parkerlab-external/UltracoldPCB-DDS/DDS.brd

## EAGLE design DDS.brd (2025-03-03)

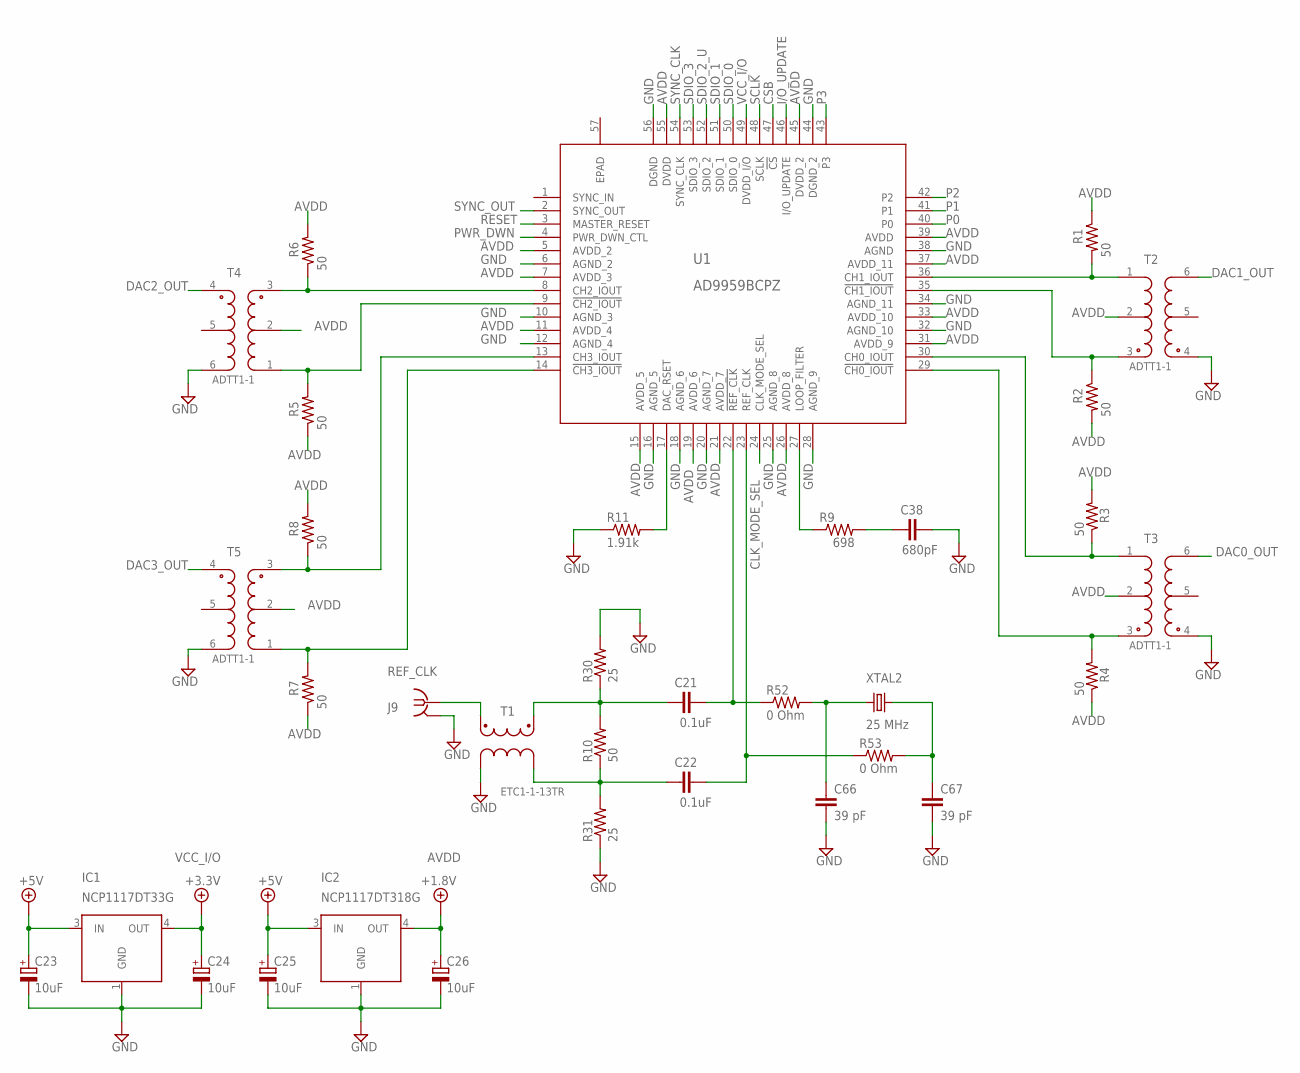
[picture p1: schematic DDS.sch, sheet 1]

Parts:
C21, C22: 0.1uF; C0402; MPN C0402C104K4RACTU
C23, C24, C25, C26: 10uF; CT3528; MPN T494B106K025AT
C38: 680pF; C0805; MPN MC0805N681J101CT
C66, C67: 39 pF; C0805; MPN MC0805N390J500CT
IC1: NCP1117DT33G; D-PAK_TO252AA; MPN NCP1117DT33G
IC2: NCP1117DT318G; D-PAK_TO252AA; MPN NCP1117DT18G
J9: REF_CLK; BU-SMA-V; MPN 142-0701-231
R1, R2, R3, R4, R5, R6, R7, R8, R10: 50; R0603; MPN CRCW060350R0FKEA
R9: 698; R0603; MPN ERJ-3EKF6980V
R11: 1.91k; R0603; MPN CRCW06031K91FKEA
R30, R31: 25; R0402; MPN NRC04F24R9TRF
R52, R53: 0 Ohm; R0402; MPN ERJ2GE0R00X
T1: ETC1-1-13TR; SM22
T2, T3, T4, T5: ADTT1-1; ADTT
U1: AD9959BCPZ; CP_56_1_ADI
XTAL2: 25 MHz; HC49UP

Connections:
+5V: C23.+, C25.+, IC1.3 (IN), IC2.3 (IN); also elsewhere on the board
AVDD: C26.+, IC2.4 (OUT), R1.1, R2.2, R3.2, R4.1, R5.1, R6.2, R7.1, R8.2, T2.2 (PRI0), T3.2 (PRI0), T4.2 (PRI0), T5.2 (PRI0), U1.5 (AVDD_2), U1.7 (AVDD_3), U1.11 (AVDD_4), U1.15 (AVDD_5), U1.19 (AVDD_6), U1.21 (AVDD_7), U1.26 (AVDD_8), U1.31 (AVDD_9), U1.33 (AVDD_10), U1.37 (AVDD_11), U1.39 (AVDD), U1.45 (DVDD_2), U1.55 (DVDD); also elsewhere on the board
CLK_MODE_SEL: U1.24 (CLK_MODE_SEL); also elsewhere on the board
CSB: U1.47 (!CS); also elsewhere on the board
DAC0_OUT: T3.6 (SEC-); also elsewhere on the board
DAC1_OUT: T2.6 (SEC-); also elsewhere on the board
DAC2_OUT: T4.4 (SEC+); also elsewhere on the board
DAC3_OUT: T5.4 (SEC+); also elsewhere on the board
GND: C23.-, C24.-, C25.-, C26.-, C38.2, C66.2, C67.2, IC1.1 (GND), IC2.1 (GND), J9.2 (GND), J9.3 (GND), J9.4 (GND), J9.5 (GND), R11.1, R30.2, R31.1, T1.4, T2.4 (SEC+), T3.4 (SEC+), T4.6 (SEC-), T5.6 (SEC-), U1.6 (AGND_2), U1.10 (AGND_3), U1.12 (AGND_4), U1.16 (AGND_5), U1.18 (AGND_6), U1.20 (AGND_7), U1.25 (AGND_8), U1.28 (AGND_9), U1.32 (AGND_10), U1.34 (AGND_11), U1.38 (AGND), U1.44 (DGND_2), U1.56 (DGND); also elsewhere on the board
I/O_UPDATE: U1.46 (I/O_UPDATE); also elsewhere on the board
unnamed: C21.1, R10.2, R30.1, T1.1
unnamed: R6.1, T4.3 (PRI+), U1.8 (CH2_IOUT)
unnamed: R5.2, T4.1 (PRI-), U1.9 (!CH2_IOUT)
unnamed: R4.2, T3.3 (PRI+), U1.29 (!CH0_IOUT)
unnamed: R1.2, T2.1 (PRI-), U1.36 (CH1_IOUT)
unnamed: R11.2, U1.17 (DAC_RSET)
unnamed: R9.1, U1.27 (LOOP_FILTER)
unnamed: C38.1, R9.2
unnamed: R7.2, T5.1 (PRI-), U1.14 (!CH3_IOUT)
unnamed: C66.1, R52.2, XTAL2.1
unnamed: R3.1, T3.1 (PRI-), U1.30 (CH0_IOUT)
unnamed: C67.1, R53.2, XTAL2.2
unnamed: C21.2, R52.1, U1.22 (!REF_CLK)
unnamed: C22.1, R10.1, R31.2, T1.3
unnamed: J9.1, T1.5
unnamed: C22.2, R53.1, U1.23 (REF_CLK)
unnamed: R8.1, T5.3 (PRI+), U1.13 (CH3_IOUT)
unnamed: R2.1, T2.3 (PRI+), U1.35 (!CH1_IOUT)
P0: U1.40 (P0); also elsewhere on the board
P1: U1.41 (P1); also elsewhere on the board
P2: U1.42 (P2); also elsewhere on the board
P3: U1.43 (P3); also elsewhere on the board
PWR_DWN: U1.4 (PWR_DWN_CTL); also elsewhere on the board
RESET: U1.3 (MASTER_RESET); also elsewhere on the board
SCLK: U1.48 (SCLK); also elsewhere on the board
SDIO_0: U1.50 (SDIO_0); also elsewhere on the board
SDIO_1: U1.51 (SDIO_1); also elsewhere on the board
SDIO_2_U: U1.52 (SDIO_2); also elsewhere on the board
SDIO_3: U1.53 (SDIO_3); also elsewhere on the board
SYNC_CLK: U1.54 (SYNC_CLK)
SYNC_OUT: U1.2 (SYNC_OUT)
VCC_I/O: C24.+, IC1.4 (OUT), U1.49 (DVDD_I/O); also elsewhere on the board

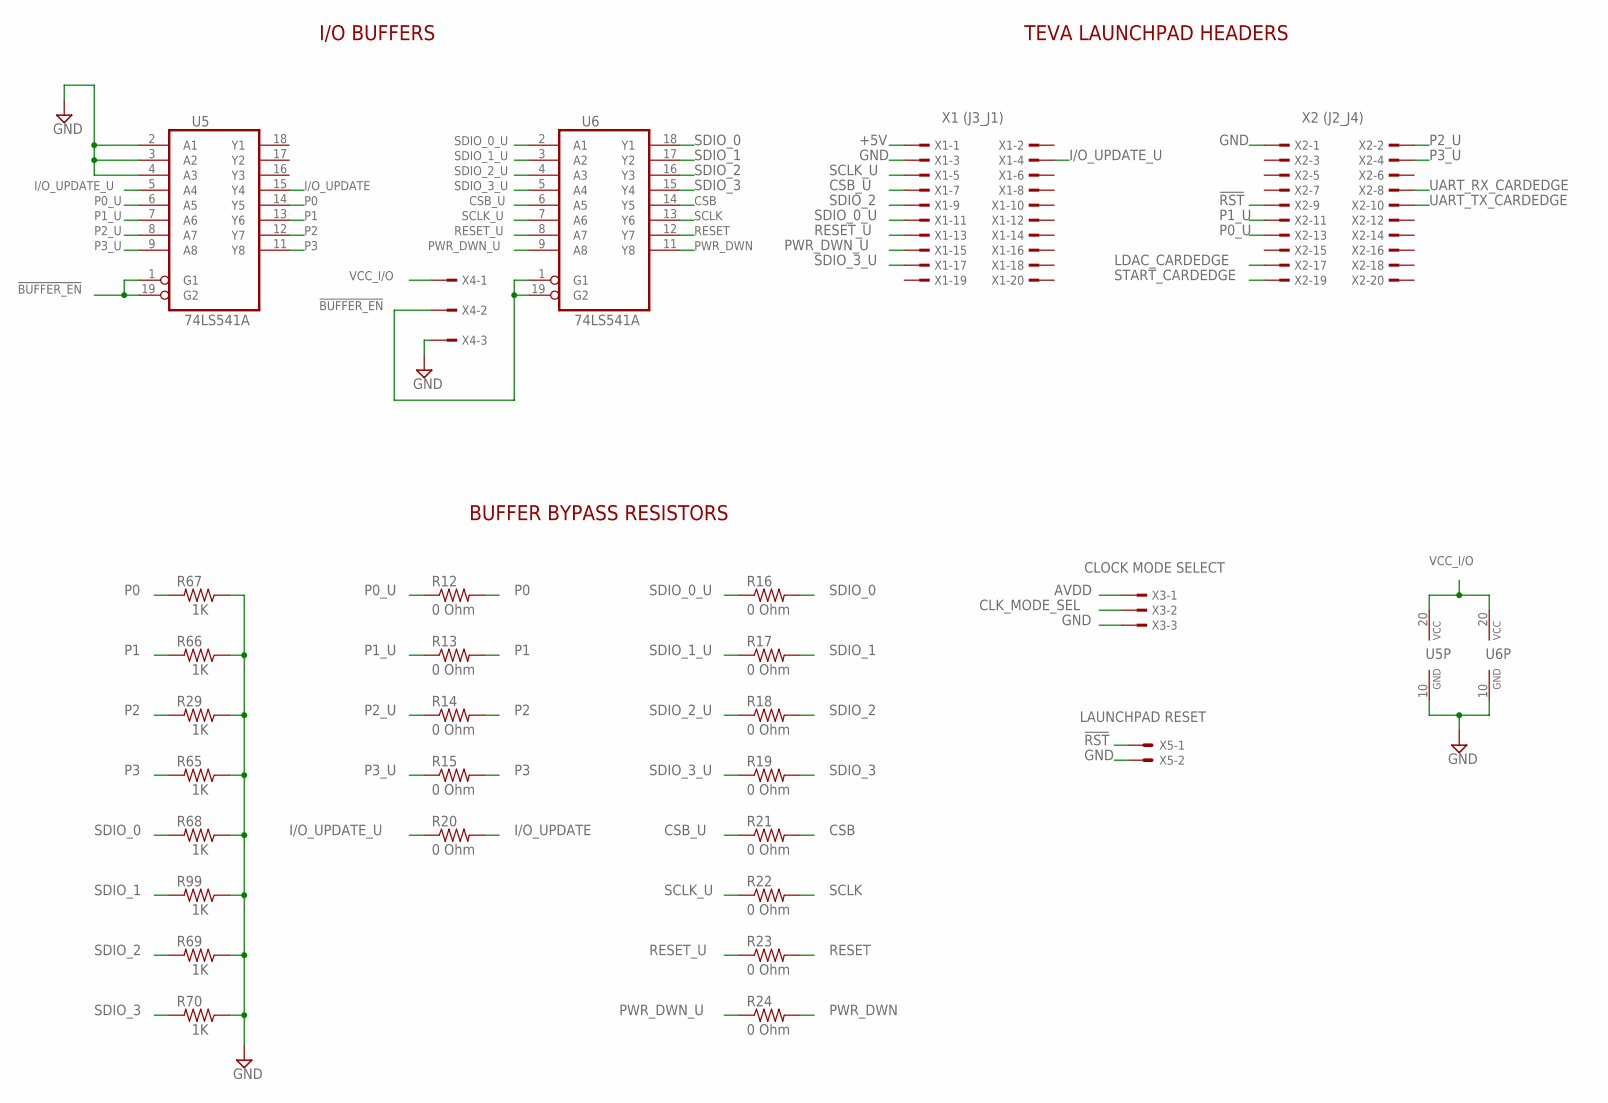
[picture p2: schematic DDS.sch, sheet 2]

Parts:
R12, R13, R14, R15, R16, R17, R18, R19, R20, R21, R22, R23, R24: 0 Ohm; R0402; MPN ERJ2GE0R00X
R29, R65, R66, R67, R68, R69, R70, R99: 1K; R0603; MPN ERJ-3EKF1001V
U5, U6: 74LS541A; SO20W; MPN SN74LVC541APW
X1: X1 (J3_J1); TSW-110-XX-G-D
X2: X2 (J2_J4); TSW-110-XX-G-D
X3: CLOCK MODE SELECT; TSW-103-XX-G-S
X4: BUFFER; TSW-103-XX-G-S
X5: LAUNCHPAD RESET; 22-23-2021

Connections:
!BUFFER_EN: U5.1 (G1), U5.19 (G2), U6.1 (G1), U6.19 (G2), X4.2
!RST: X2.9, X5.1
+5V: X1.1; also elsewhere on the board
AVDD: X3.1; also elsewhere on the board
CLK_MODE_SEL: X3.2; also elsewhere on the board
CSB: R21.2, U6.14 (Y5); also elsewhere on the board
CSB_U: R21.1, U6.6 (A5), X1.7
GND: R29.1, R65.1, R66.1, R67.1, R68.1, R69.1, R70.1, R99.1, U5.2 (A1), U5.3 (A2), U5.4 (A3), U5.10 (GND), U6.10 (GND), X1.3, X2.1, X3.3, X4.3, X5.2; also elsewhere on the board
I/O_UPDATE: R20.2, U5.15 (Y4); also elsewhere on the board
I/O_UPDATE_U: R20.1, U5.5 (A4), X1.4
LDAC_CARDEDGE: X2.17
P0: R12.2, R67.2, U5.14 (Y5); also elsewhere on the board
P0_U: R12.1, U5.6 (A5), X2.13
P1: R13.2, R66.2, U5.13 (Y6); also elsewhere on the board
P1_U: R13.1, U5.7 (A6), X2.11
P2: R14.2, R29.2, U5.12 (Y7); also elsewhere on the board
P2_U: R14.1, U5.8 (A7), X2.2
P3: R15.2, R65.2, U5.11 (Y8); also elsewhere on the board
P3_U: R15.1, U5.9 (A8), X2.4
PWR_DWN: R24.2, U6.11 (Y8); also elsewhere on the board
PWR_DWN_U: R24.1, U6.9 (A8), X1.15
RESET: R23.2, U6.12 (Y7); also elsewhere on the board
RESET_U: R23.1, U6.8 (A7), X1.13
SCLK: R22.2, U6.13 (Y6); also elsewhere on the board
SCLK_U: R22.1, U6.7 (A6), X1.5
SDIO_0: R16.2, R68.2, U6.18 (Y1); also elsewhere on the board
SDIO_0_U: R16.1, U6.2 (A1), X1.11
SDIO_1: R17.2, R99.2, U6.17 (Y2); also elsewhere on the board
SDIO_1_U: R17.1, U6.3 (A2)
SDIO_2: R18.2, R69.2, U6.16 (Y3), X1.9
SDIO_2_U: R18.1, U6.4 (A3); also elsewhere on the board
SDIO_3: R19.2, R70.2, U6.15 (Y4); also elsewhere on the board
SDIO_3_U: R19.1, U6.5 (A4), X1.17
START_CARDEDGE: X2.19
UART_RX_CARDEDGE: X2.8
UART_TX_CARDEDGE: X2.10
VCC_I/O: U5.20 (VCC), U6.20 (VCC), X4.1; also elsewhere on the board

Notes on the sheet:
I/O BUFFERS
TEVA LAUNCHPAD HEADERS
BUFFER BYPASS RESISTORS

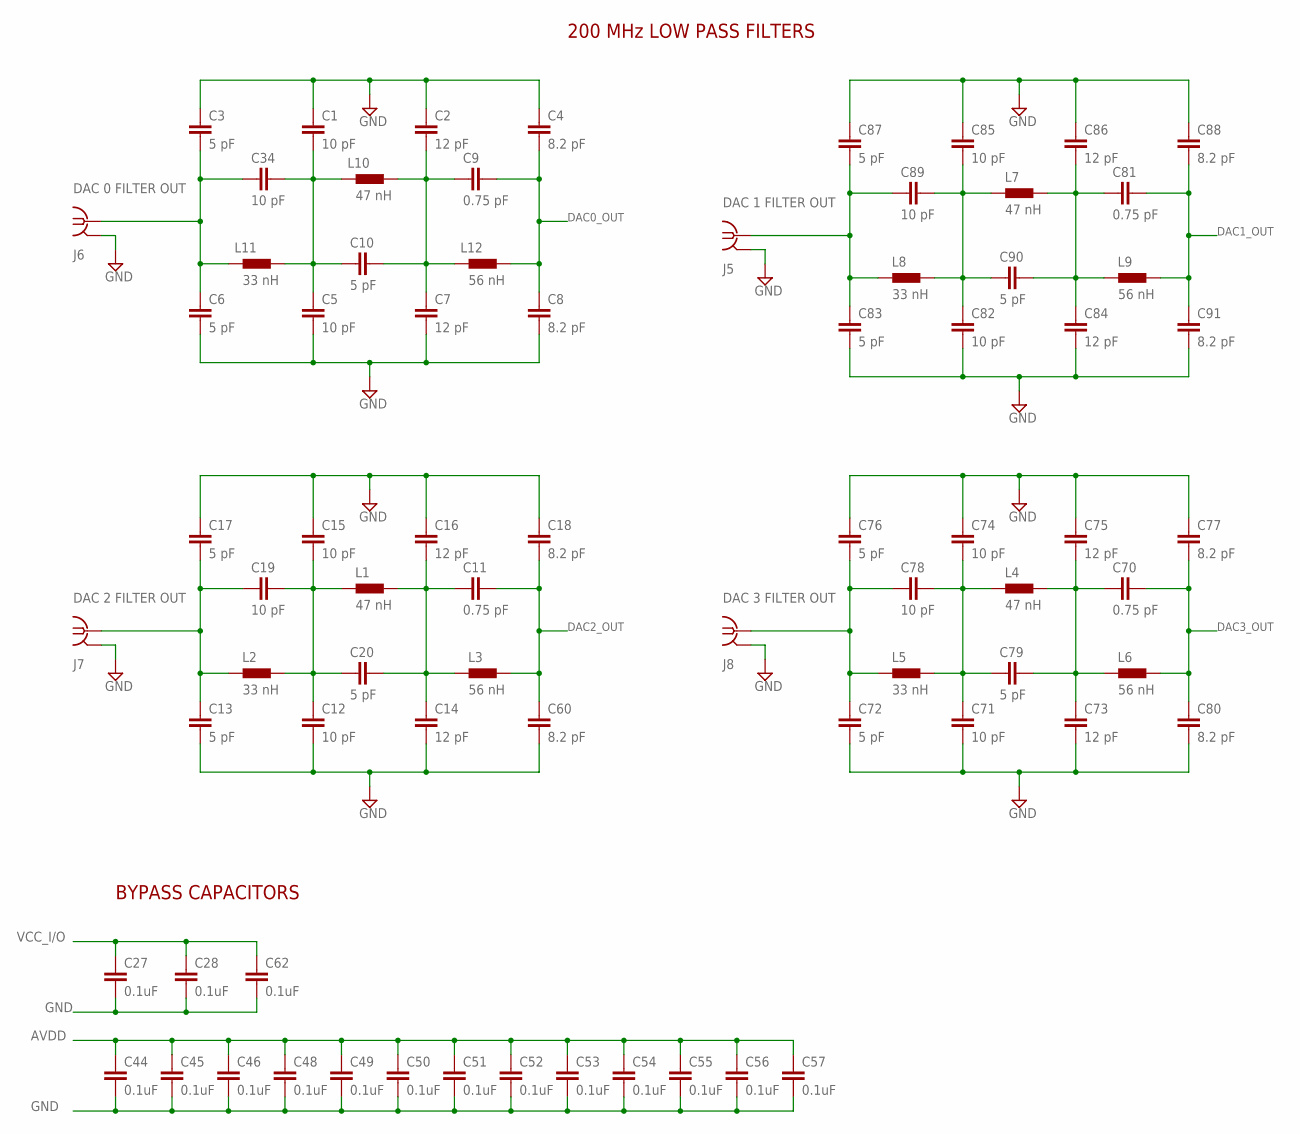
[picture p3: schematic DDS.sch, sheet 3]

Parts:
C1, C5, C12, C15, C19, C34, C71, C74, C78, C82, C85, C89: 10 pF; C0402; MPN CL05C100JB5NNNC
C2, C7, C14, C16, C73, C75, C84, C86: 12 pF; C0402; MPN 04025A120JAT2A
C3, C6, C10, C13, C17, C20, C72, C76, C79, C83, C87, C90: 5 pF; C0402; MPN GJM1555C1H5R0CB01D
C4, C8, C18, C60, C77, C80, C88, C91: 8.2 pF; C0402; MPN 04025A8R2BAT2A
C9, C11, C70, C81: 0.75 pF; C0402; MPN GJM1555C1HR75BB01D
C27, C28: 0.1uF; C0603; MPN 06035C104KAT2A
C44, C45, C46, C48, C49, C50, C51, C52, C53, C54, C55, C56, C57, C62: 0.1uF; C0402; MPN C0402C104K4RACTU
J5: DAC 1 FILTER OUT; BU-SMA-V; MPN 142-0701-231
J6: DAC 0 FILTER OUT; BU-SMA-V; MPN 142-0701-231
J7: DAC 2 FILTER OUT; BU-SMA-V; MPN 142-0701-231
J8: DAC 3 FILTER OUT; BU-SMA-V; MPN 142-0701-231
L1, L4, L7, L10: 47 nH; 0402; MPN LQG15HN47NJ02D
L2, L5, L8, L11: 33 nH; 0402; MPN LQG15HS33NJ02D
L3, L6, L9, L12: 56 nH; 0402; MPN LQG15HS56NJ02D

Connections:
AVDD: C44.1, C45.1, C46.1, C48.1, C49.1, C50.1, C51.1, C52.1, C53.1, C54.1, C55.1, C56.1, C57.1; also elsewhere on the board
DAC0_OUT: C4.2, C8.1, C9.1, L12.2; also elsewhere on the board
DAC1_OUT: C81.1, C88.2, C91.1, L9.2; also elsewhere on the board
DAC2_OUT: C11.1, C18.2, C60.1, L3.2; also elsewhere on the board
DAC3_OUT: C70.1, C77.2, C80.1, L6.2; also elsewhere on the board
GND: C1.1, C2.1, C3.1, C4.1, C5.2, C6.2, C7.2, C8.2, C12.2, C13.2, C14.2, C15.1, C16.1, C17.1, C18.1, C27.2, C28.2, C44.2, C45.2, C46.2, C48.2, C49.2, C50.2, C51.2, C52.2, C53.2, C54.2, C55.2, C56.2, C57.2, C60.2, C62.2, C71.2, C72.2, C73.2, C74.1, C75.1, C76.1, C77.1, C80.2, C82.2, C83.2, C84.2, C85.1, C86.1, C87.1, C88.1, C91.2, J5.2 (GND), J5.3 (GND), J5.4 (GND), J5.5 (GND), J6.2 (GND), J6.3 (GND), J6.4 (GND), J6.5 (GND), J7.2 (GND), J7.3 (GND), J7.4 (GND), J7.5 (GND), J8.2 (GND), J8.3 (GND), J8.4 (GND), J8.5 (GND); also elsewhere on the board
unnamed: C81.2, C84.1, C86.2, C90.1, L7.2, L9.1
unnamed: C83.1, C87.2, C89.2, J5.1, L8.1
unnamed: C82.1, C85.2, C89.1, C90.2, L7.1, L8.2
unnamed: C13.1, C17.2, C19.2, J7.1, L2.1
unnamed: C2.2, C7.1, C9.2, C10.1, L10.2, L12.1
unnamed: C3.2, C6.1, C34.2, J6.1, L11.1
unnamed: C1.2, C5.1, C10.2, C34.1, L10.1, L11.2
unnamed: C11.2, C14.1, C16.2, C20.1, L1.2, L3.1
unnamed: C12.1, C15.2, C19.1, C20.2, L1.1, L2.2
unnamed: C70.2, C73.1, C75.2, C79.1, L4.2, L6.1
unnamed: C72.1, C76.2, C78.2, J8.1, L5.1
unnamed: C71.1, C74.2, C78.1, C79.2, L4.1, L5.2
VCC_I/O: C27.1, C28.1, C62.1; also elsewhere on the board

Notes on the sheet:
200 MHz LOW PASS FILTERS
BYPASS CAPACITORS

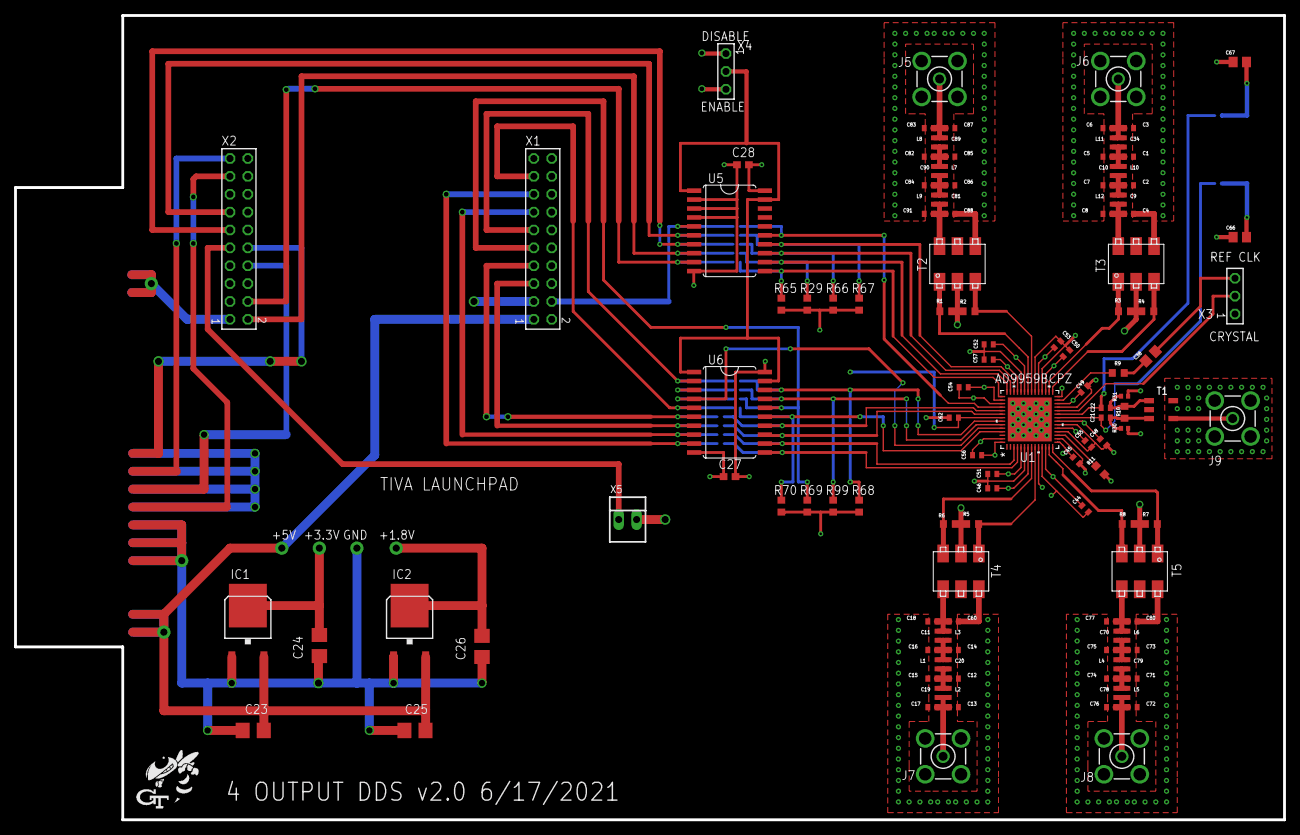
[picture p4: board DDS.brd from above]

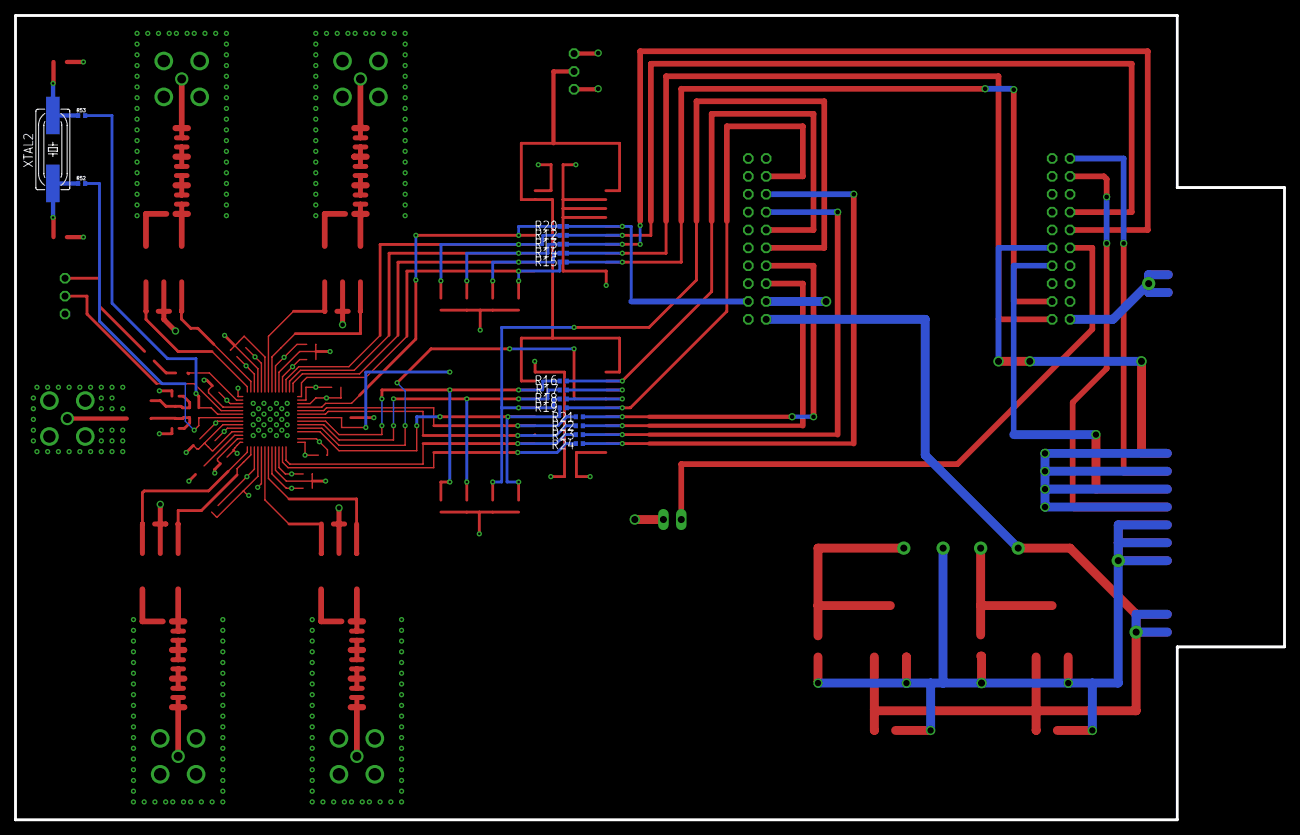
[picture p5: board DDS.brd from below]

Board: 4 copper layers, 180.3 x 114.3 mm, 138 parts (16 on the bottom side), 67 nets.
